MatsRobot/Mobility-Scooter-Battery-Capacity-Tester/Veroboard Back.jpg

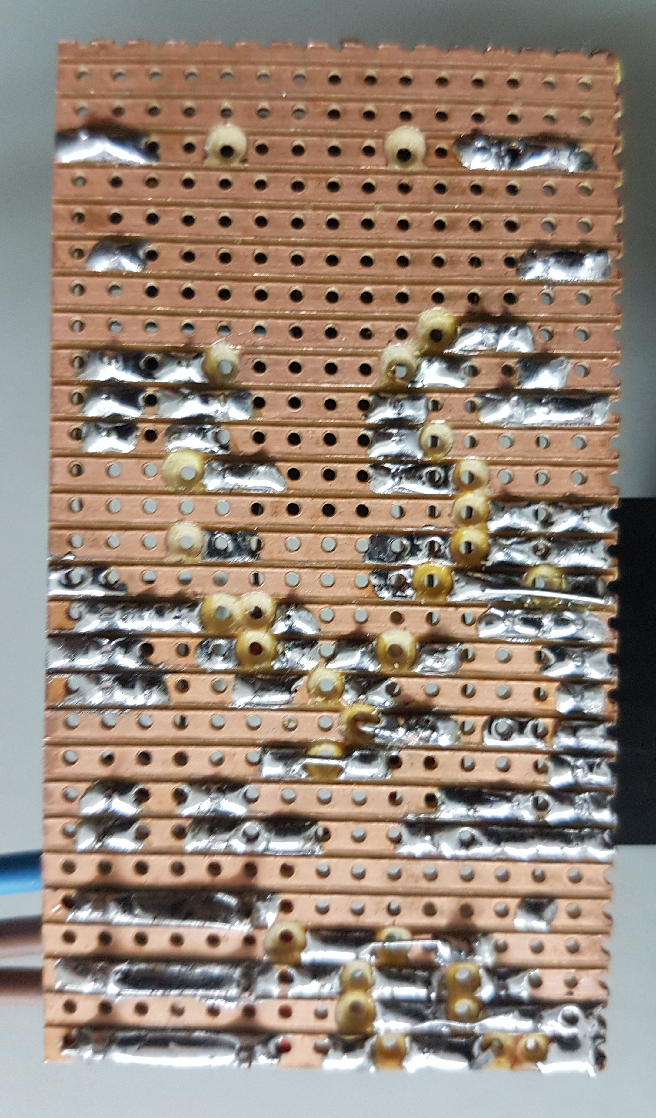
Veroboard Back.jpg
