MatsRobot/Mobility-Scooter-Battery-Capacity-Tester/Circuit 1.jpg

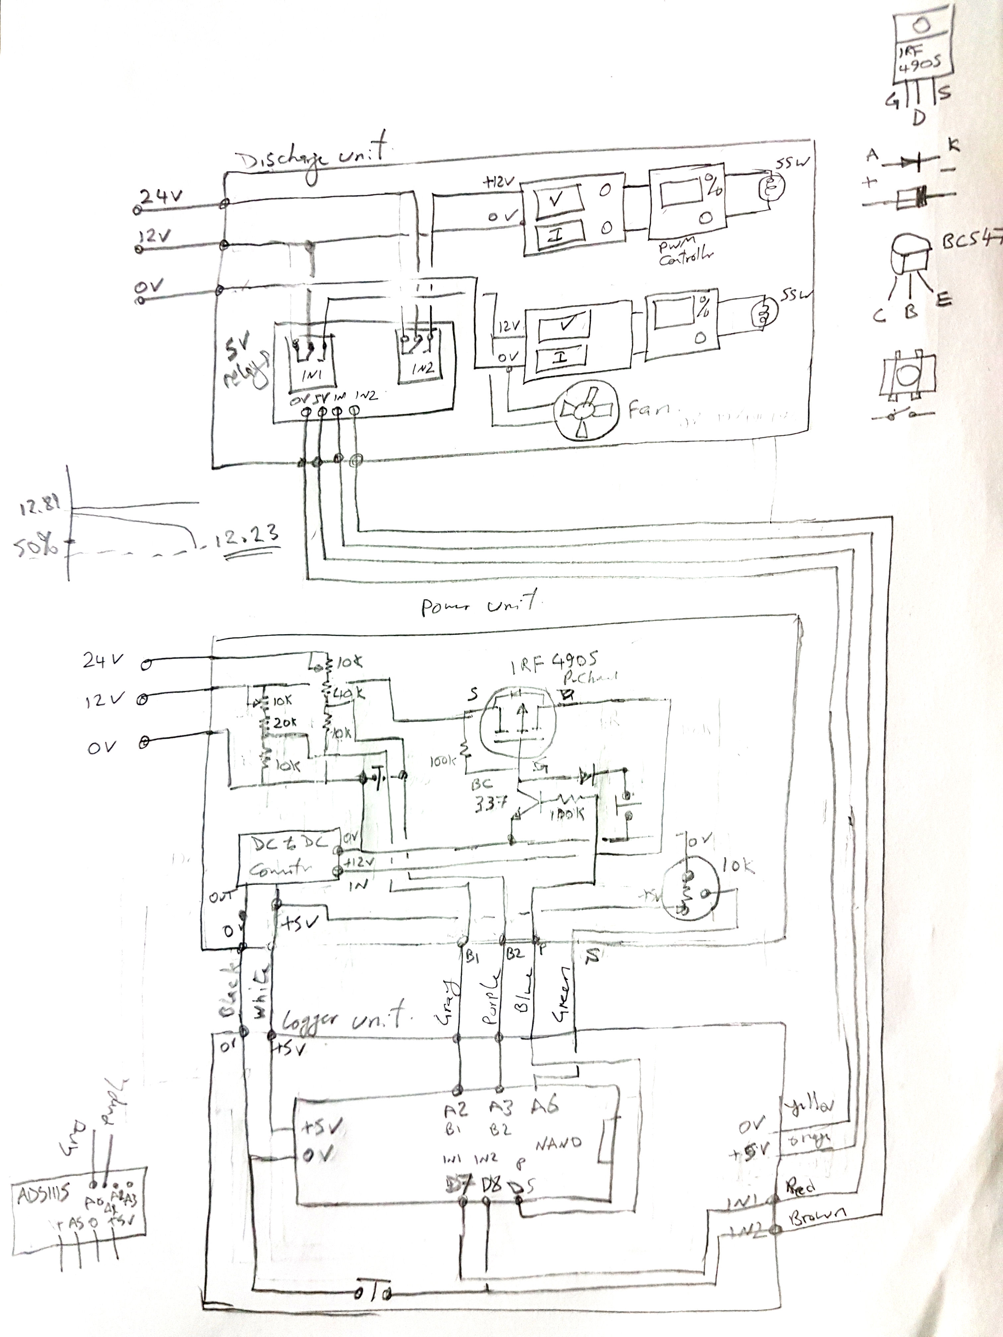
Circuit 1.jpg
