MatsRobot/Mobility-Scooter-Battery-Capacity-Tester/Unit Without Load.jpg

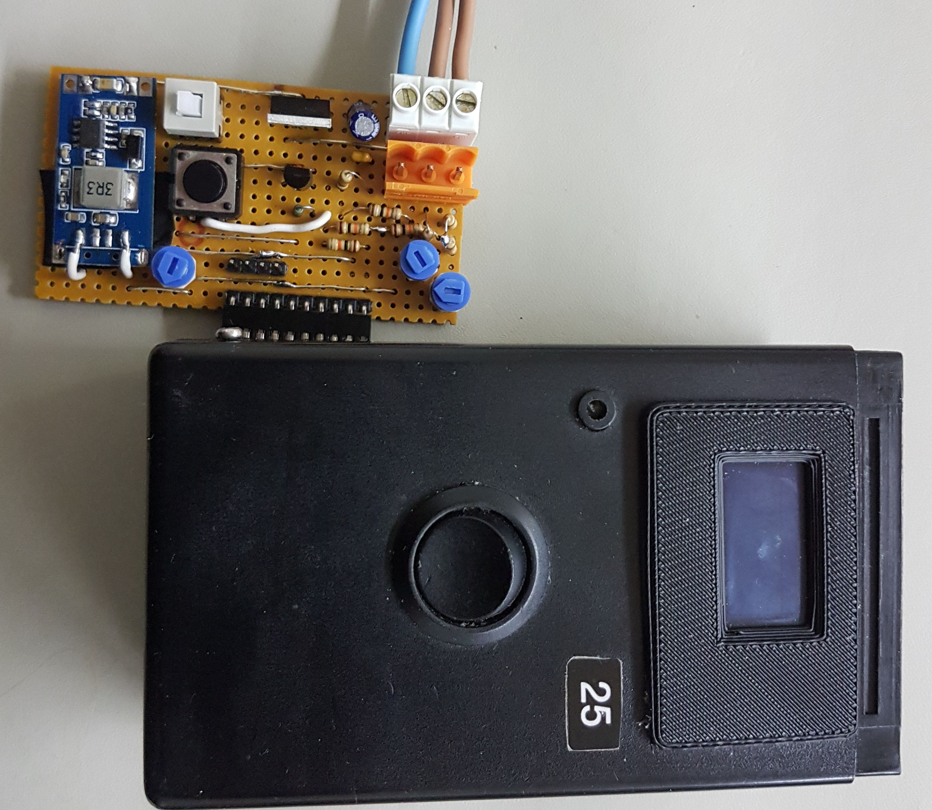
Unit Without Load.jpg
