MatsRobot/Mobility-Scooter-Battery-Capacity-Tester/Veroboard Front.jpg

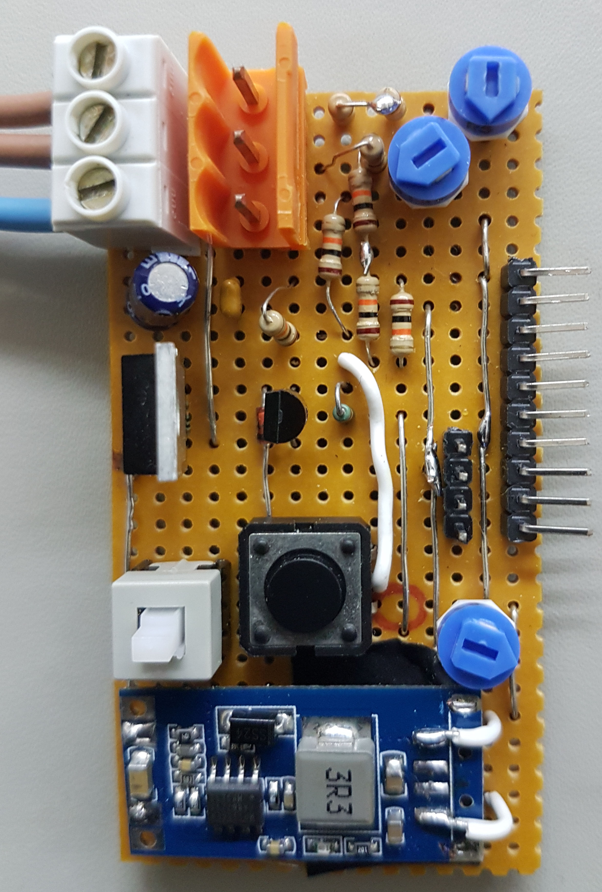
Veroboard Front.jpg
