MatsRobot/Mobility-Scooter-Battery-Capacity-Tester/LeadAcidBatteryTester_Circuit.jpg

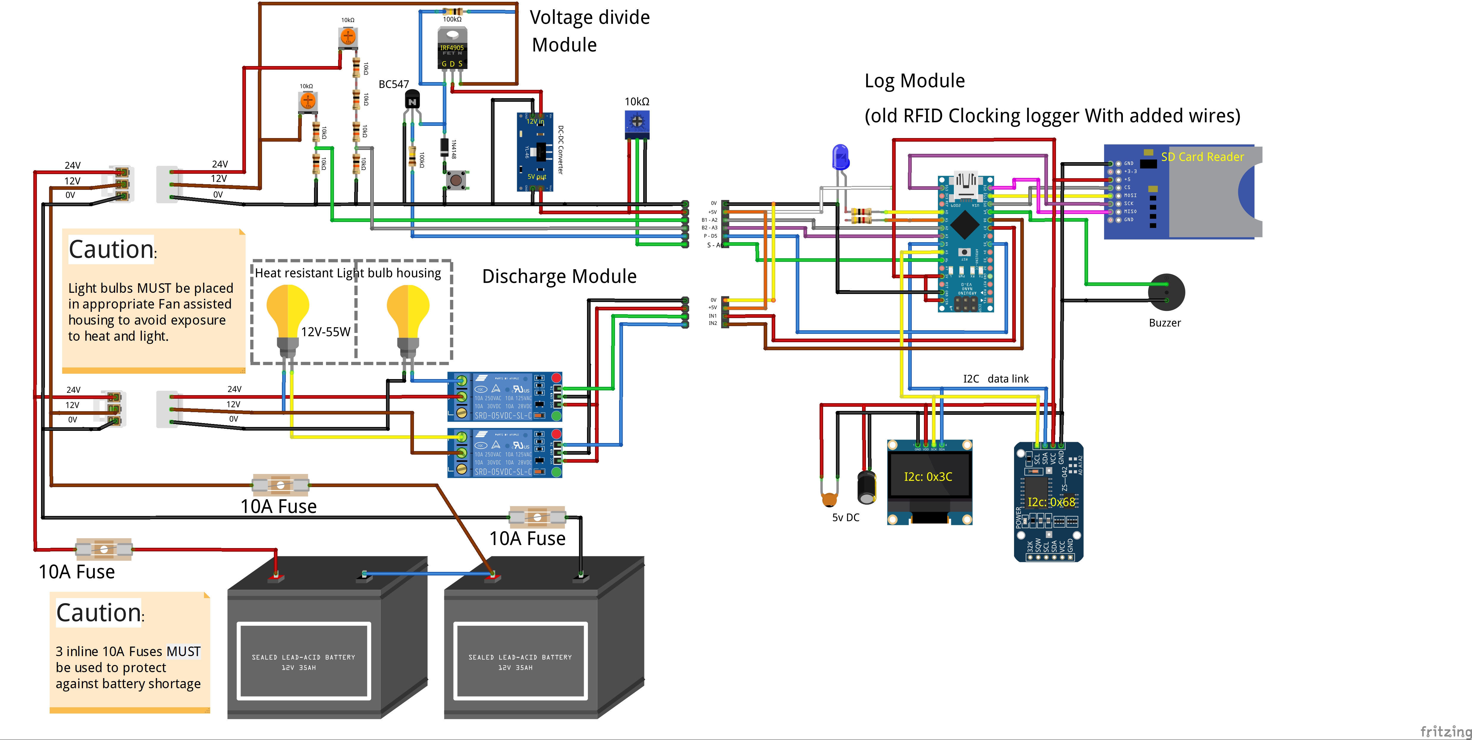
LeadAcidBatteryTester_Circuit.jpg
