MatsRobot/Mobility-Scooter-Battery-Capacity-Tester/Vero board design.jpg

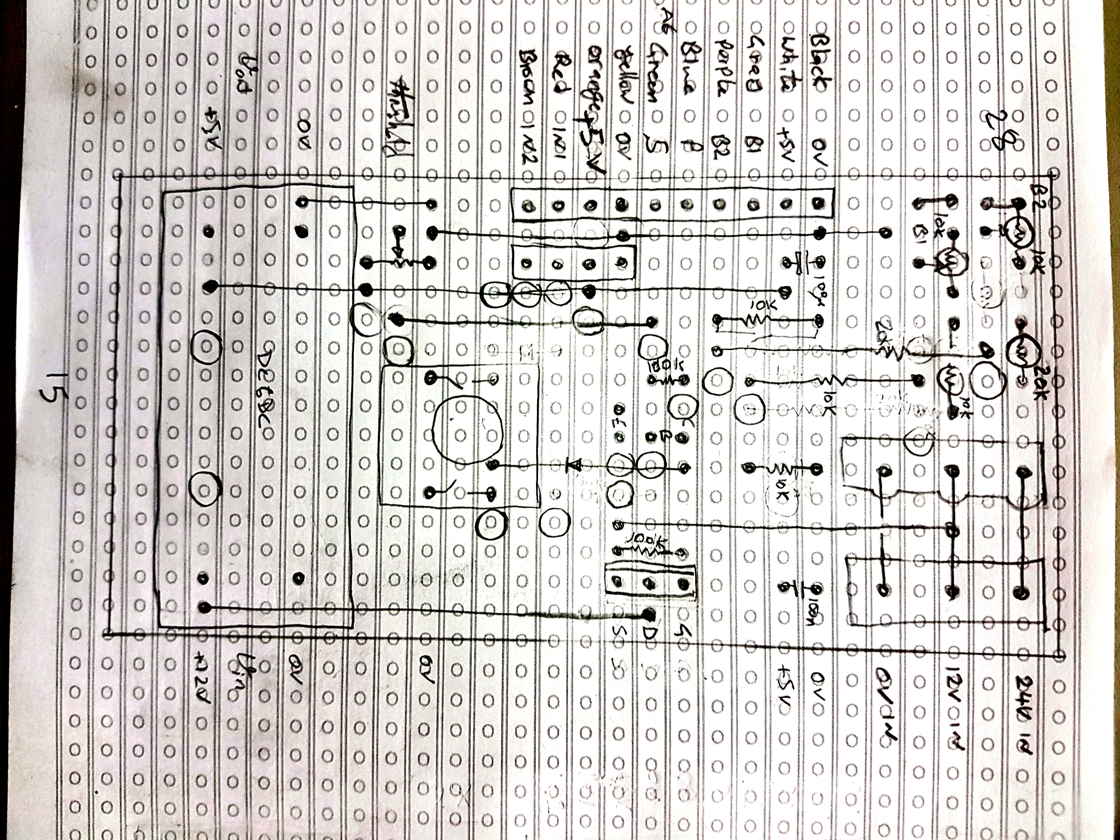
Vero board design.jpg
